Ede1vveiss/TPI/3-Documents/Pre-TPI/1391-3501-00 Rapport Liste de modification.docx

wETML

Pre-TPI Liste de modifications proposés du PCB Démonstrateur PID

Rapport R&D

Eden Wegger Funderskov

06/03/2024

Versions

Version | Date | Auteur | Remarques
00 | 2024-02-29 | EFV | Version initiale

# 1 Routage de l’alimentation

Durant le module de T&M5 j’ai eu la chance de toucher un peu au code de ce projet, cependant en mon ordinateur portable étant déjà connecté au nucléo pour le programmer, après avoir connecté le PCB j’ai remarqué que mon ordinateur portable n’était plus fonctionnel. (Il s’est avéré qu’il y a eu un courant en retour dans le port de charge usb, détruisant la carte mère)

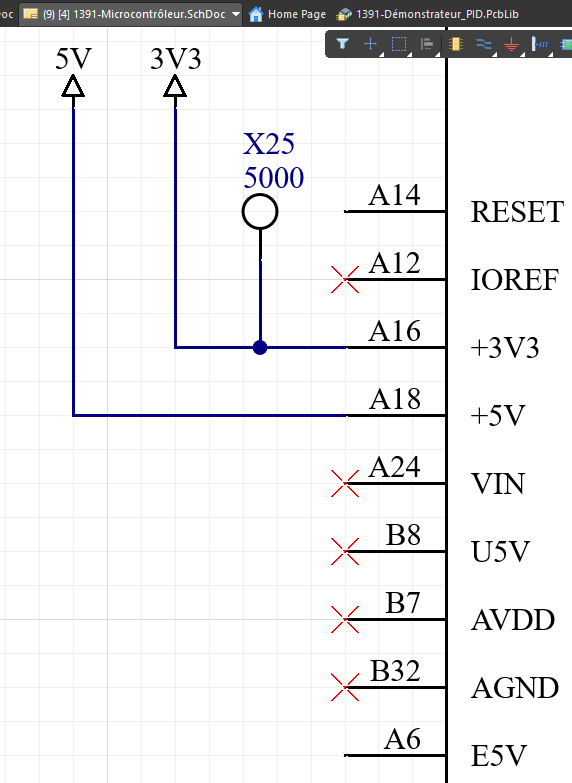
[picture p8: figure]
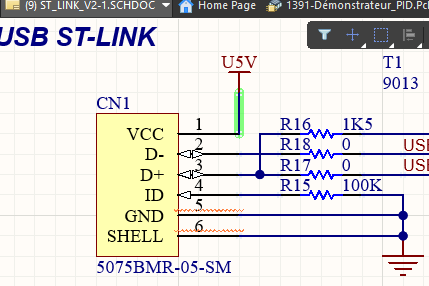
[picture p9: figure]
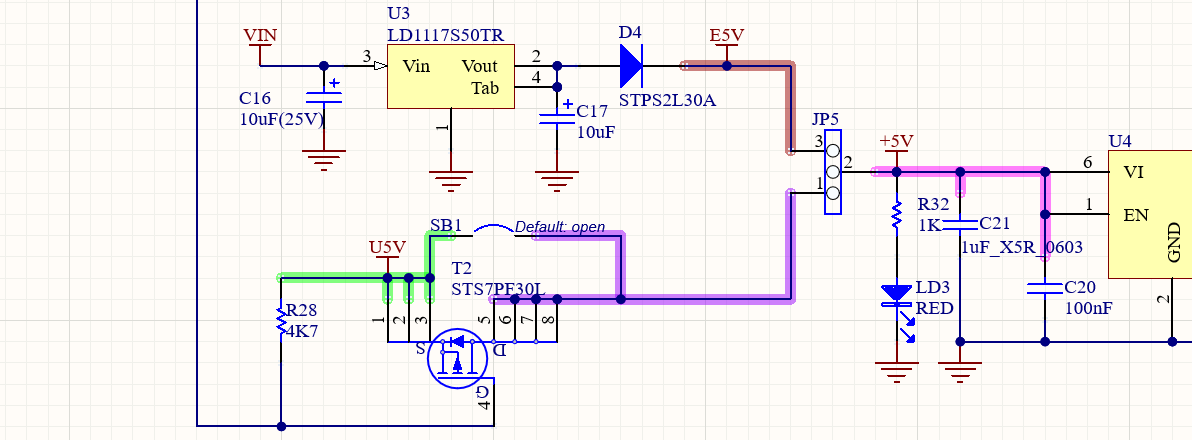
[picture p10: figure]

La cause que j’ai maintenant découvert durant mon pré-TPI est que le nucléo était alimenté par sa sortie +5V, alors que le port pour alimenter le nucléo est soi le Vin, ou soi le port E5V

Src : schémas du Nucléo F070RB

De ce que j’ai observé dans les datasheets, il n’existe pas une solution qui empêchera un risque à l’ordinateur connecté au Nucléo. Autre que des précautions d’utilisation, notamment d’alimenter le PCBA en premier puis connecter l’ordinateur au Nucléo. Cependant cela nécessitera de déconnecter l’ordi en cas de coupure de l’alimentation du PCBA.

# 2 Orientation des potentiomètres

Comme indiqué par l’auteur précédent du projet, il faut corriger les footprints des potentiomètres afin d’assurer que tourner les potentiomètres dans le sens des aiguilles d’une montre ou élever/éloigner le curseur du potentiomètre à barrette, de soi, augmente la valeur ADC obtenue sur le Nucléo.

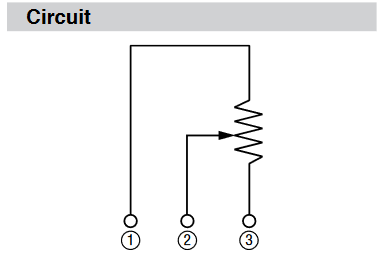
[picture p11: figure]

Dans la version que j’ai récupérée, le curseur des potentiomètres n’était pas sur le bon pin selon les datasheets.

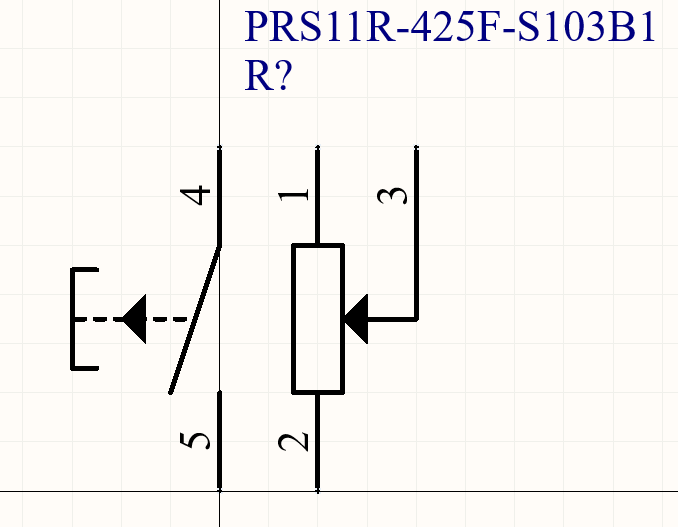
[picture p12: figure]
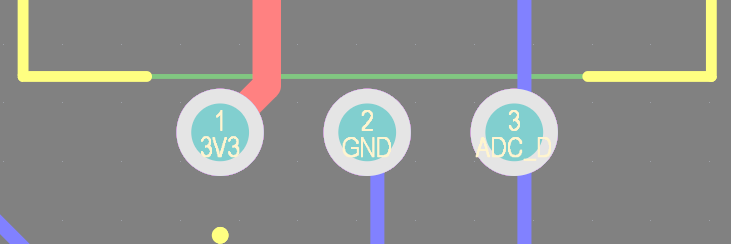
[picture p13: figure]

# 3 Taille des composants SMD

Voyant toute l’espace disponible sur le PCB il n’y a aucune raison, pour laquelle il serait nécessaire d’utiliser des composants aussi petites. En particulier pour les résistances et condensateurs

Page 2 sur 4

Auteur : EF Modifié par : Dernière modification le 06/03/2024 15:19 Page 0 sur 3 Créé le 29/02/2024 Imprimé le 23/03/2023 14:30 1391-3501-00 Rapport Liste de modification.docx

ETML Section électronique EFV – R&D – 1391.3503.00

ETML Section électronique TBI – R&D – 1391.3500.00
