Ede1vveiss/TPI/5-Hardware/1391-Demonstrateur_PID/1391-Démonstrateur_PID.html

Reporting Options

# File in Newer Format

Date | : | 20/03/2023
Time | : | 19:53:59
Project name | : | C:\Users\Xeryo\Education Vaud\ETML_XLO-19-23 - Blatti\Projets\1391-Demonstrateur_de_regulation_PID_TPI\5-Hardware\1391-Demonstrateur_PID\1391-Démonstrateur_PID.PrjPcb
Schematic documents | : | 1391-Affichage led.SchDoc , 1391-Alimentation.SchDoc , 1391-Microcontrôleur.SchDoc , 1391-Régulation.SchDoc , 1391-Schéma bloc.SchDoc

Version | Warning
21.9.0 | Internal Pull Up/Down resistor in components are not supported in this version.
22.3.0 | Custom diff pair suffixes are not supported in this version.

These files were generated in a later version of Altium Designer. Be aware that some data may have been added through functionality not available in your current version and will therefore not be available to you.
