Ede1vveiss/TPI/3-Documents/TPI/Mode d'emploi régulateur PID.docx

# Mode d’emploi Régulateur PID

# 1 But

Le but de ce document est de décrire succinctement l’utilisation du régulateur PID.

# 2 branchement

Vérifier qu’un nucléo STM32 F040RB est présent sur la carte avec le code de régulation dedans. Comme ci-dessous.

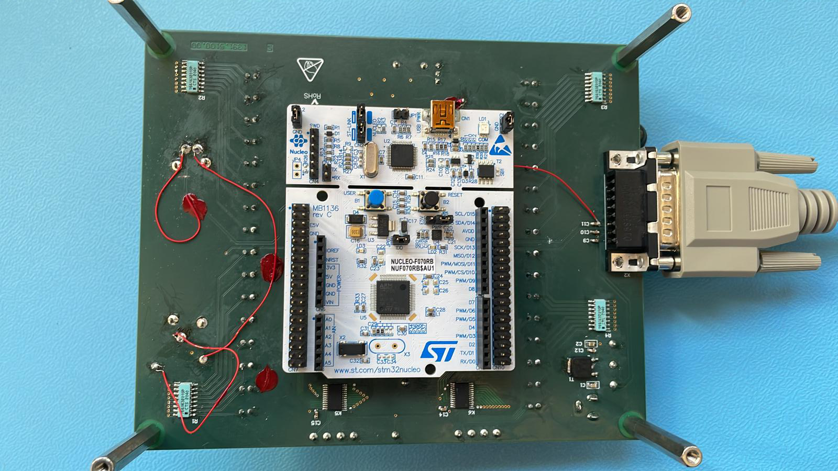
[picture p36: figure]

1 Carte nucléo

Si l’étape d’avant est validée vous pouvez alimenter la carte comme décris ci-dessous.

La carte est alimentée en 12V grâce à l’alimentation externe de la carte. Voir image ci-dessous.

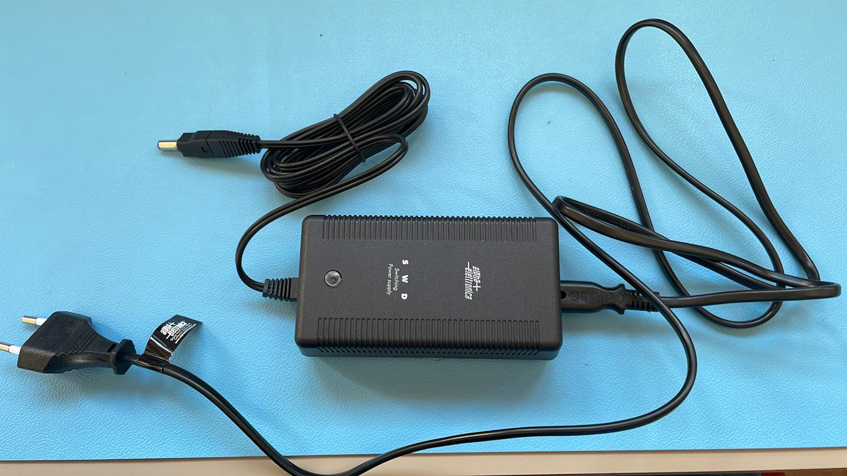
[picture p37: figure]

2 Alimentation

Assurez-vous que la carte est connectée à la tour grâce son câble Sub-D 15.

# 3 Utilisation

Voici une description visuelle de la carte.

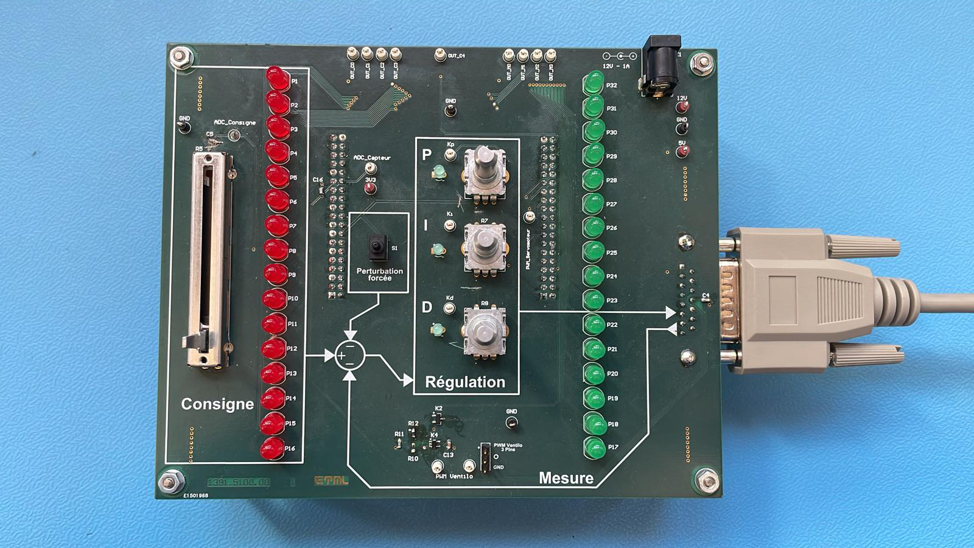
[picture p38: figure]

Sur la gauche de la carte, le potentiomètre linéaire permet de choisir à quelle hauteur la balle devrait monter avec sa représentation sur les leds rouge.

Au milieu se situe un bouton poussoir pour ajouter une erreur manuellement dans la régulation.

Les 3 potentiomètres P, I, D permettent de gérer précisément les valeurs de leur coefficient respectif.

A droite est représentée la valeur de la mesure sur les leds vertes en comparaison avec la valeur de consigne.

En bas se situe le système de choix n fonction de quel type de ventilateur est utilisé. (3pins ou 4pins)

Lausanne, le 10 mai 2023

Auteur : TB Modifié par : Dernière modification le 10/05/2023 14:32 Page 2 sur 2 Créé le 10/05/2023 Imprimé le 10/05/2023 14:33 Mode d'emploi régulateur PID.docx

Créé le 10/05/2023 Dernière modification le 10/05/2023 14:32 Page 1 sur 1 Imprimé le 10/05/2023 14:33 Mode d'emploi régulateur PID.docx

ETML Section électronique TBI – Mode d’emploi – 1391.3700.00
