Ede1vveiss/TPI/3-Documents/TPI/Structogramme/1391_Démonstrateur_PID.png

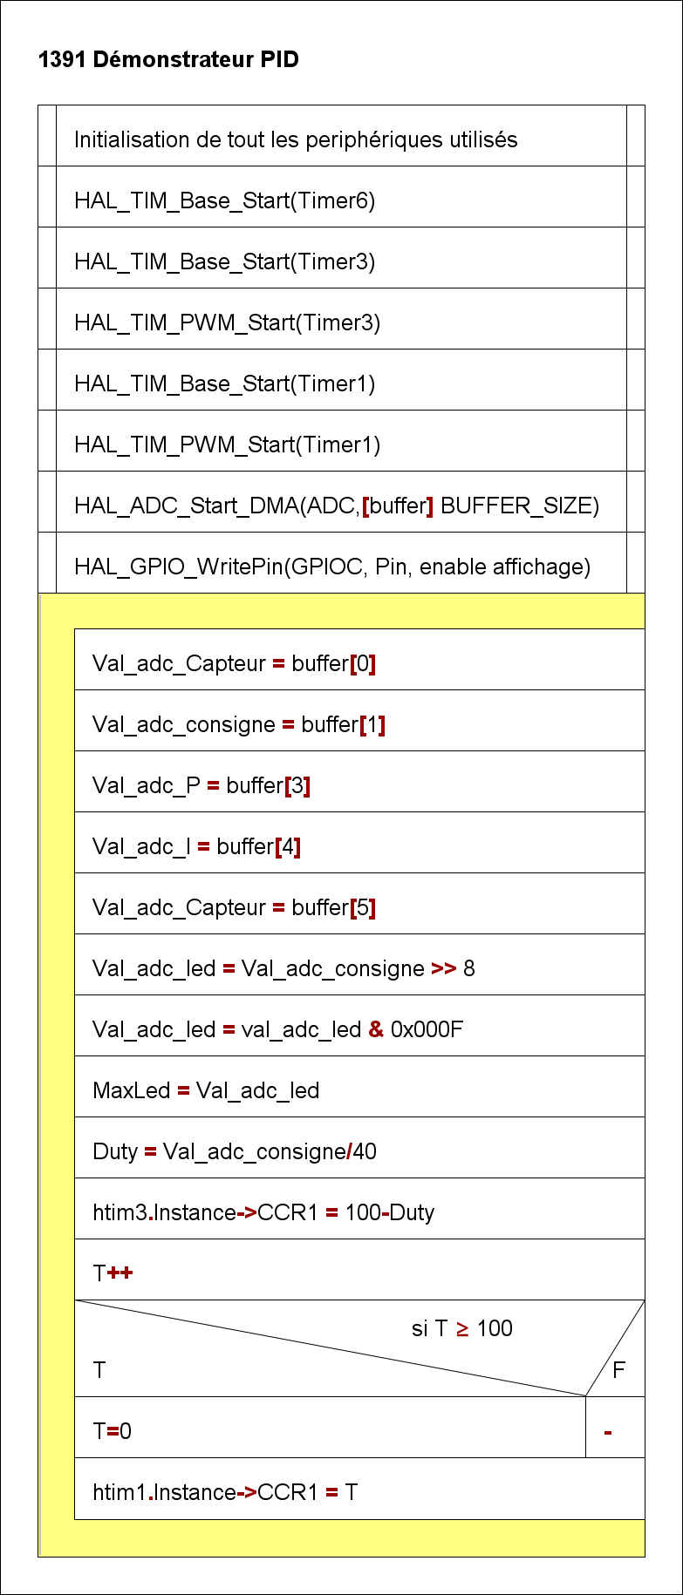
3-Documents/TPI/Structogramme/1391_Démonstrateur_PID.png
