Ede1vveiss/TPI/3-Documents/TPI/Structogramme/Affichage.png

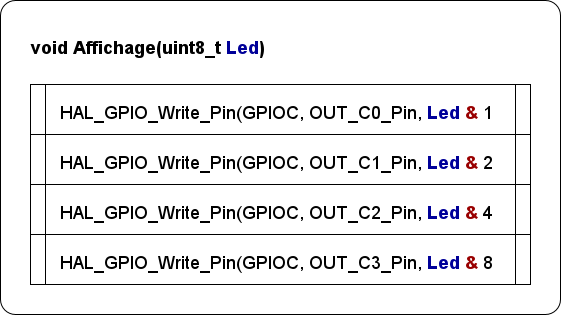
3-Documents/TPI/Structogramme/Affichage.png
