Ede1vveiss/TPI/3-Documents/TPI/Structogramme/ChoixLed-1.png

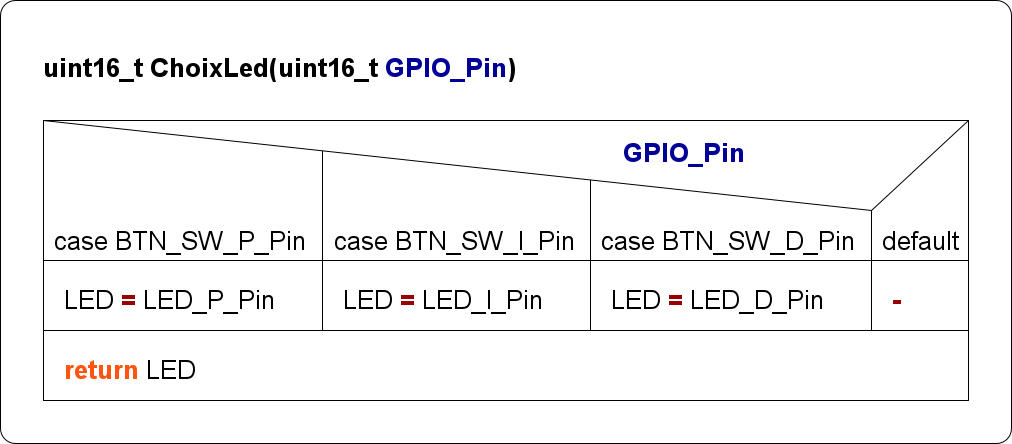
3-Documents/TPI/Structogramme/ChoixLed-1.png
