Ede1vveiss/TPI/3-Documents/TPI/Structogramme/HAL_GPIO_EXTI_Callback.png

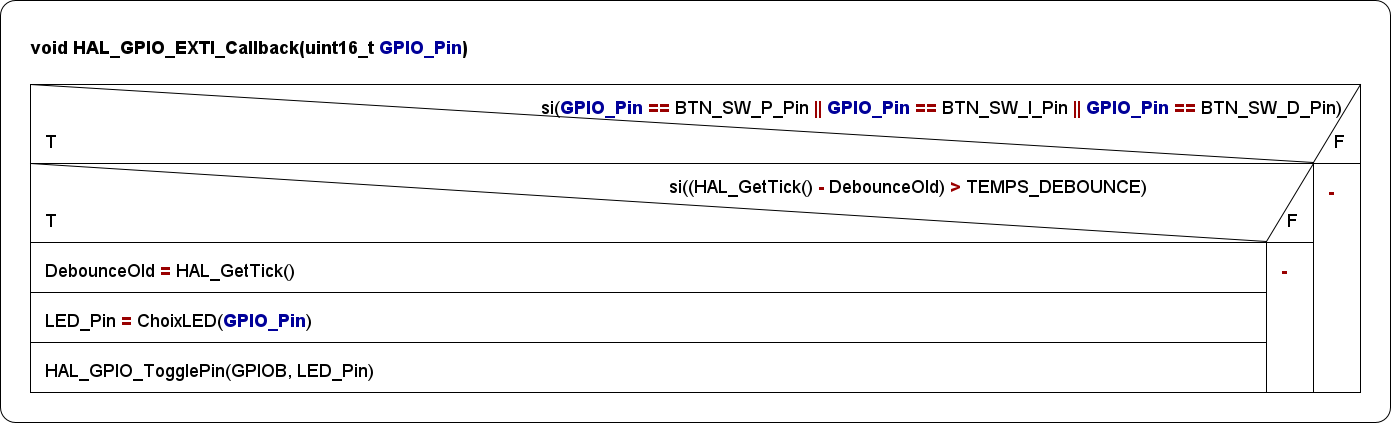
3-Documents/TPI/Structogramme/HAL_GPIO_EXTI_Callback.png
