Ede1vveiss/TPI/3-Documents/TPI/Structogramme/HAL_TIM_PeriodElapsedCallback.png

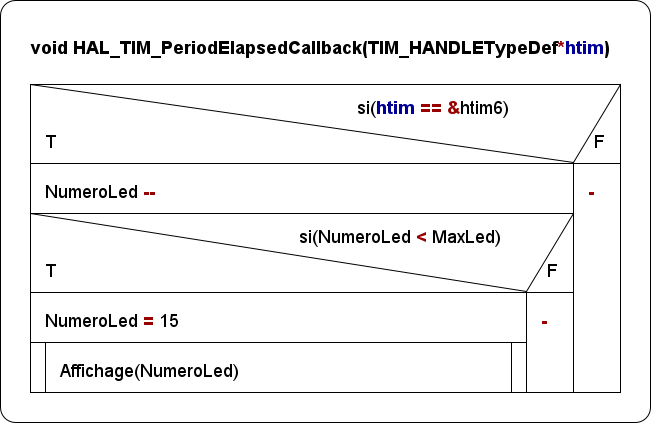
3-Documents/TPI/Structogramme/HAL_TIM_PeriodElapsedCallback.png
