Ede1vveiss/TPI/5-Hardware/1391-Demonstrateur_PID/Assembly/1391-Démonstrateur_PID_BOM.xlsx

 | Titre | Démonstrateur-PID |  | Numéro | 1391.5600.00 |  | ETML
 | Devise | <none> |  | Dessiné | TBI | 2023-03-16
 | Qté production | 1 |  | Controlé | - | -
Pos. | Designator | Description | PN | Quantity | Supplier 1 | Supplier Part Number 1 | Supplier Price 1 | Order Qty | Total | IsStocked
1 | 1 | PCB element for BOM | PN-108075 | 1 | Eurocircuits Sàrl | - | 0.0000 | 1 | 0.0000 | FALSE
2 | C1 | CAPC 100nF X7R 50V 10% 2012 (0805 INCH) | PN-747862 | 1 | ETML | FAB.0805_C 100n | 0.0200 | 1 | 0.0200 | 1
3 | C2 | CAPC 1uF X5R 25V 10% 2012 (0805 INCH) | PN-324029 | 1 | ETML | FAB.0805_C 1u | 0.0223 | 1 | 0.0223 | 1
4 | C3, C9, C10, C11, C12, C13, C14, C15 | CAPC 100nF X7R 50V 10% 1608 (0603 INCH) | PN-338083 | 8 | ETML | FAB.0603_C 100n | 0.0100 | 8 | 0.0800 | 1
5 | C4, C5, C6, C7, C8, C16 | CAPC 10nF X7R 50V 10% 1608 (0603 INCH) | PN-514948 | 6 | ETML | FAB.0603_C 10nF | 0.0123 | 6 | 0.0738 | 1
6 | K1 | NUCLEO-F070RB |  | 1 | Digikey | 497-15095-ND | 10.2200 | 1 | 10.2200
7 | K2 | TRAN 2N7002 N-Channel Enhancement MOSFET 60V 300mA | PN-648365 | 1 | Digikey | 2N7002K-7DITR-ND | 0.2000 | 1 | 0.2000 | 1
8 | K4 | IC BUFFER NON-INVERT 6V 5TSSOP |  | 1 | Digikey | 1727-3261-2-ND | 0.4300 | 1 | 0.4300
9 | K5, K6 | Integrated Circuit |  | 2 | Digikey | 1727-5944-2-ND | 1.5000 | 2 | 3.0000
10 | P1, P2, P3, P4, P5, P6, P7, P8, P9, P10, P11, P12, P13, P14, P15, P16 | LED 5mm 20 mA 2V 635nm Red | PN-959457 | 16 | ETML | MAG.232.228 | 0.2985 | 16 | 4.7760 | TRUE
11 | P17, P18, P19, P20, P21, P22, P23, P24, P25, P26, P27, P28, P29, P30, P31, P32 | LED 5mm 20 mA 2.4V 565nm Green | PN-297541 | 16 | ETML | MAG.232.231 | 0.1991 | 16 | 3.1856 | TRUE
12 | P36, P37, P38 | LED 3mm Cylinder 20 mA 2V 625nm Red | PN-643196 | 3 | Digikey | L71531-ND | 0.8900 | 3 | 2.6700 | FALSE
13 | R1, R2, R3, R4 | RES ARRAY 8 RES 200 OHM 16SOIC |  | 4 | Digikey | 766-163-R200P-ND | 2.0100 | 4 | 8.0400
14 | R5 | POT 10K OHM 1/20W LINEAR |  | 1 | Digikey | PTA4543-2015DPB103-ND | 1.7800 | 1 | 1.7800
15 | R6, R7, R8 | 20 mm Rotary Metal Shaft Potentiometer |  | 3 | Digikey | 118-PRS11R-225F-S103B1-ND | 3.5100 | 3 | 10.5300
16 | R9, R11, R13, R14, R15 | RES 100kohm ±1% 0.1W 1608 (0603 INCH) | PN-525286 | 5 | ETML | FAB.0603_R 100k | 0.0100 | 5 | 0.0500 | 1
17 | R10, R12 | RES 10kohm ±1% 0.1W 1608 (0603 INCH) | PN-896786 | 2 | ETML | FAB.0603_R 10k | 0.0200 | 2 | 0.0400 | 1
18 | R16, R17, R18 | RES 150ohm ±1% 0.1W 1608 (0603 INCH) | PN-977870 | 3 | ETML | FAB.0603_R 150R | 0.0200 | 3 | 0.0600 | 1
19 | S1 | A9PS26-0011 |  | 1 | Digikey | SW1380-ND | 6.0500 | 1 | 6.0500
20 | T1 | Positive Voltage Regulator, 5V, 3-Pin DPAK, Tape and Reel |  | 1 | Digikey | 497-1203-2-ND | 0.6600 | 1 | 0.6600
21 | X1 | Power Barrel Connector Jack 2.10mm ID (0.083), 5.50mm OD (0.217) Through Hole, Right Angle |  | 1 | Digikey | EJ503A-ND | 1.2800 | 1 | 1.2800
22 | X2 | Connector |  | 1 | Digikey | 609-1498-ND | 2.5100 | 1 | 2.5100
23 | X3, X4, X5, X6, X7, X8, X9, X10, X11, X12, X13, X14, X15, X22, X23, X24, X26 | TEST THT MINIATURE WT | PN-357949 | 17 | ETML | MAG.428.013 | 0.2931 | 17 | 4.9827 | TRUE
24 | X16, X17, X25 | TEST THT MINIATURE RD | PN-119866 | 3 | ETML | MAG.428.012 | 0.2708 | 3 | 0.8124 | TRUE
25 | X18, X19, X20, X21 | TEST THT MINIATURE BK | PN-688907 | 4 | ETML | MAG.428.011 | 0.2600 | 4 | 1.0400 | TRUE
26 | X28 | JUMPER 2.54 1x03 | PN-771444 | 1 | ETML | MAG.283.897 | 0.0600 | 1 | 0.0600 | TRUE
 |  |  |  |  |  |  | Totaux | 104 | 62.57
