Ede1vveiss/TPI/5-Hardware/1391-Demonstrateur_PID/3D altium library/74LVC1G125GV,125.stp

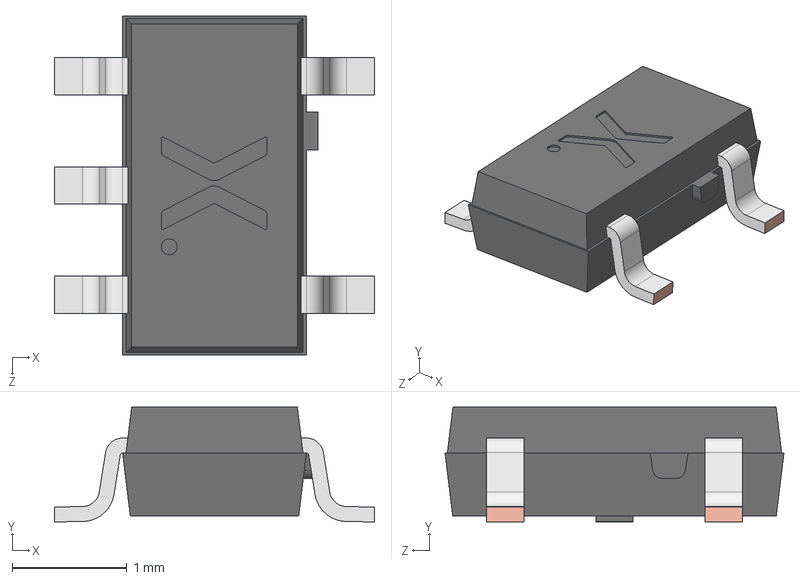
[picture p44: CAD file, 2024-03-13]
5-Hardware/1391-Demonstrateur_PID/3D altium library/74LVC1G125GV,125.stp
2.79 x 1.00 x 2.95 mm
SOT753 Lower mold body
SOT753 Lead x 5
SOT753 Upper mold body
