Ede1vveiss/TPI/5-Hardware/1391-Demonstrateur_PID/3D altium library/PTA4543-2015DPB103.step

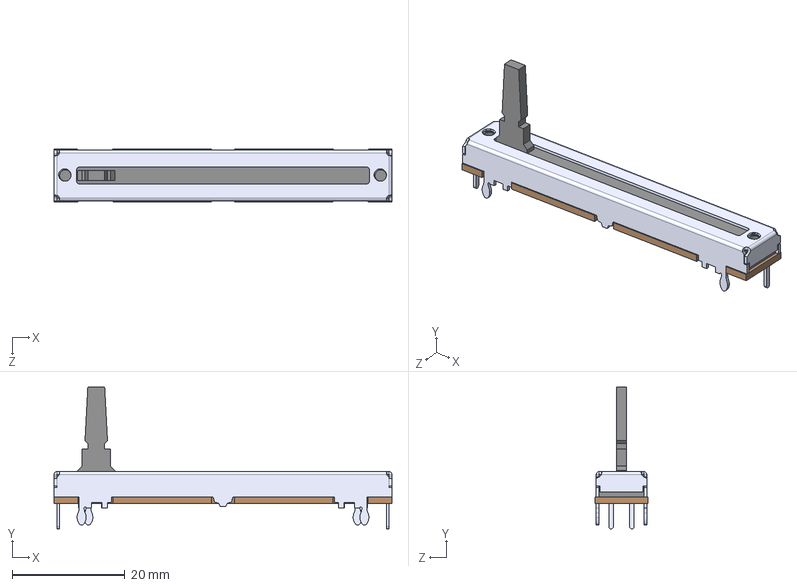
[picture p45: CAD file, 2024-03-13]
5-Hardware/1391-Demonstrateur_PID/3D altium library/PTA4543-2015DPB103.step
60.0 x 25.2 x 9.40 mm
