Ede1vveiss/TPI/5-Hardware/1391-Demonstrateur_PID/3D altium library/EJ503A.step

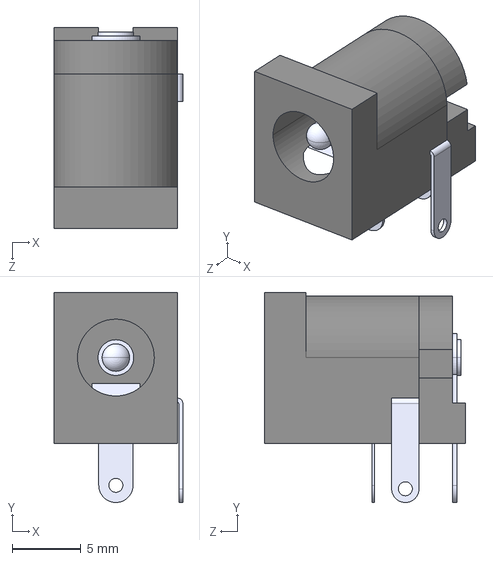
[picture p46: CAD file, 2024-03-13]
5-Hardware/1391-Demonstrateur_PID/3D altium library/EJ503A.step
9.38 x 15.3 x 14.6 mm
