Ede1vveiss/TPI/5-Hardware/1391-Demonstrateur_PID/3D altium library/MC74VHC1G08DBVT1G-Q.stp

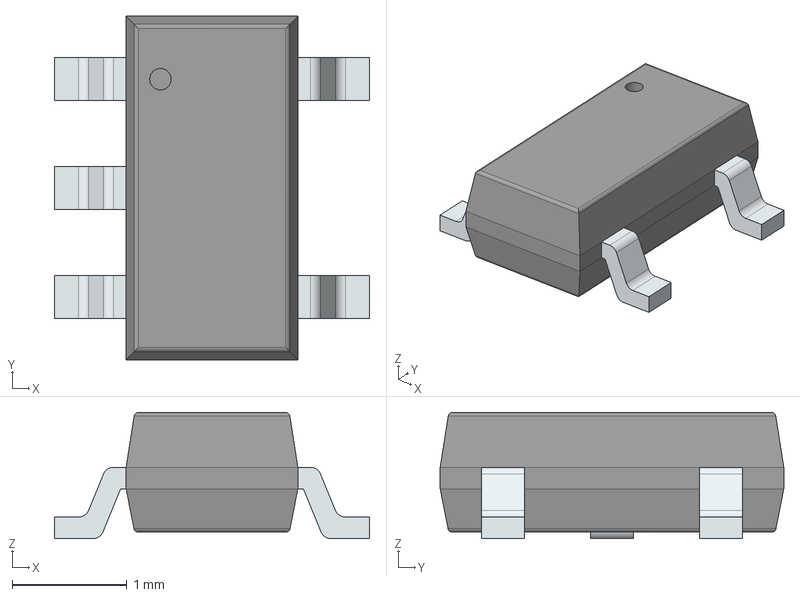
[picture p47: CAD file, 2024-03-13]
5-Hardware/1391-Demonstrateur_PID/3D altium library/MC74VHC1G08DBVT1G-Q.stp
2.75 x 3.00 x 1.10 mm
PinsArrayL
PinsArrayR
