Ede1vveiss/TPI/5-Hardware/1391-Demonstrateur_PID/Assembly/1391-Démonstrateur_PID_PCB.PDF

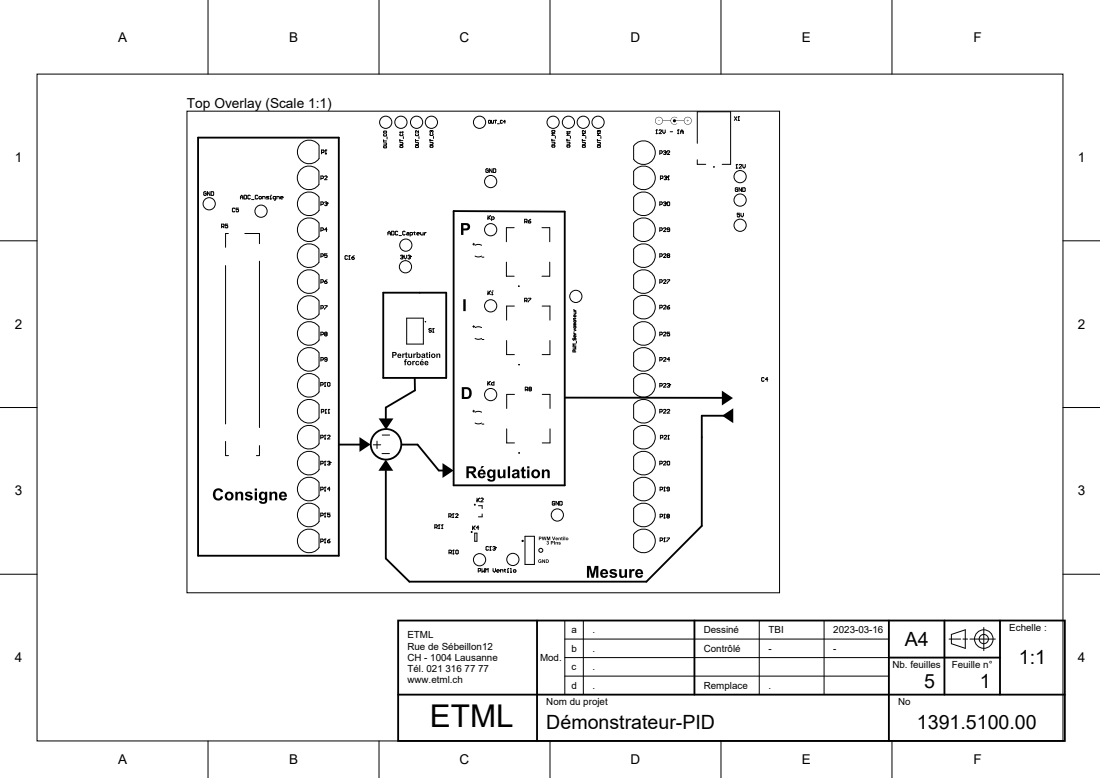
[picture p48: page 1]

ETML Rue de Sébeillon12 CH - 1004 Lausanne Tél. 021 316 77 77 www.etml.ch | Mod. | a | . | Dessiné | TBI | 2023-03-16 | A4 | | Echelle : 1:1

b | . | Contrôlé | - | -
c | . | | | | Nb. feuilles 5 | Feuille n° 1
d | . | Remplace | .

ETML | Nom du projet Démonstrateur-PID | | | | | | No 1391.5100.00

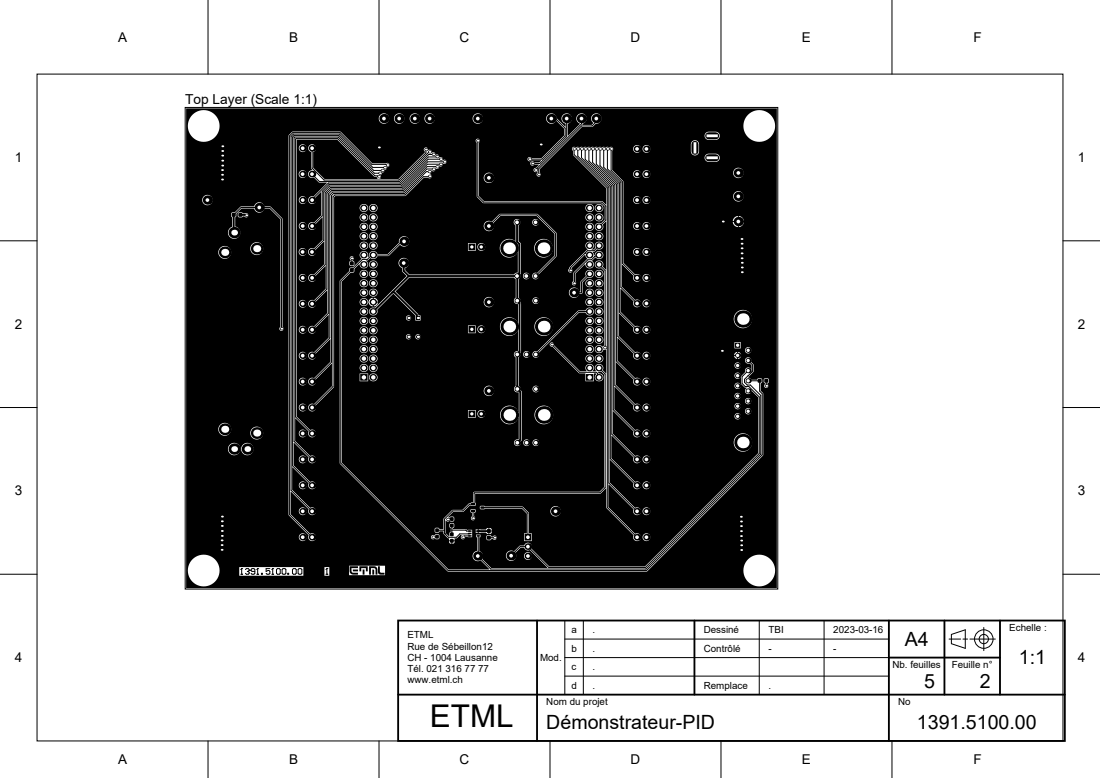
[picture p49: page 2]
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

b | . | Contrôlé | - | -
c | . | | | | Nb. feuilles 5 | Feuille n° 2
d | . | Remplace | .

ETML | Nom du projet | | | | | | No

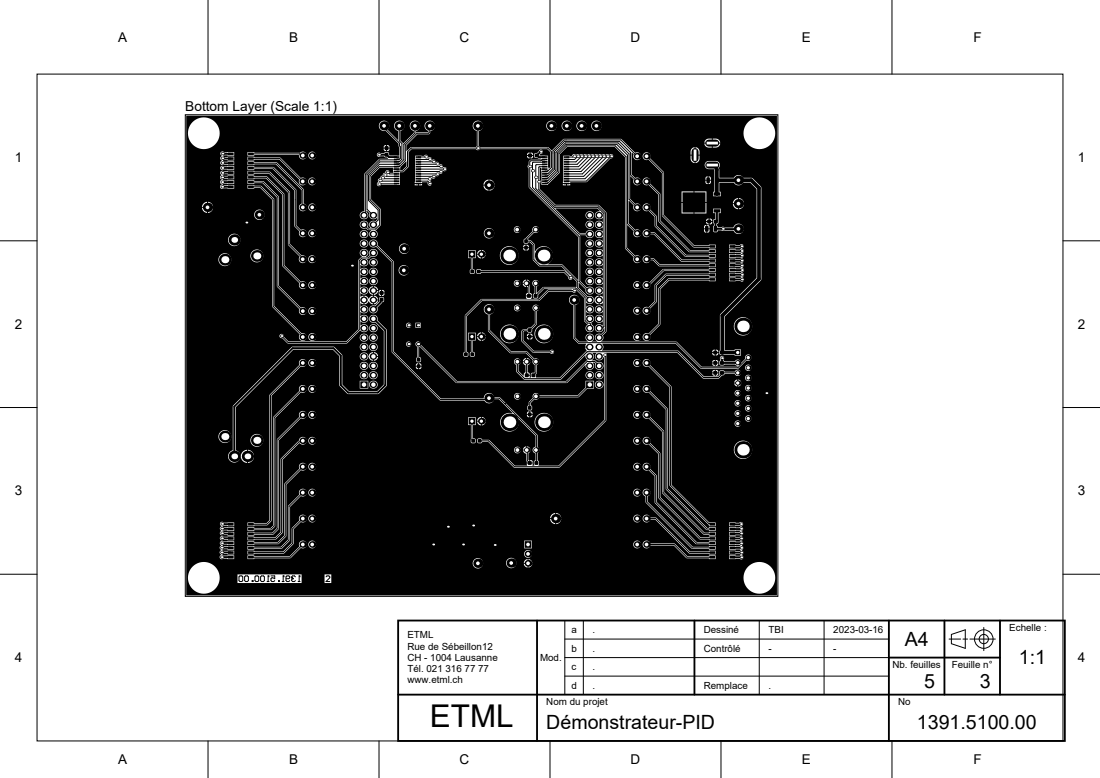
[picture p50: page 3]
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

b | . | Contrôlé | - | -
c | . | | | | Nb. feuilles 5 | Feuille n° 3
d | . | Remplace | .

ETML | Nom du projet | | | | | | No

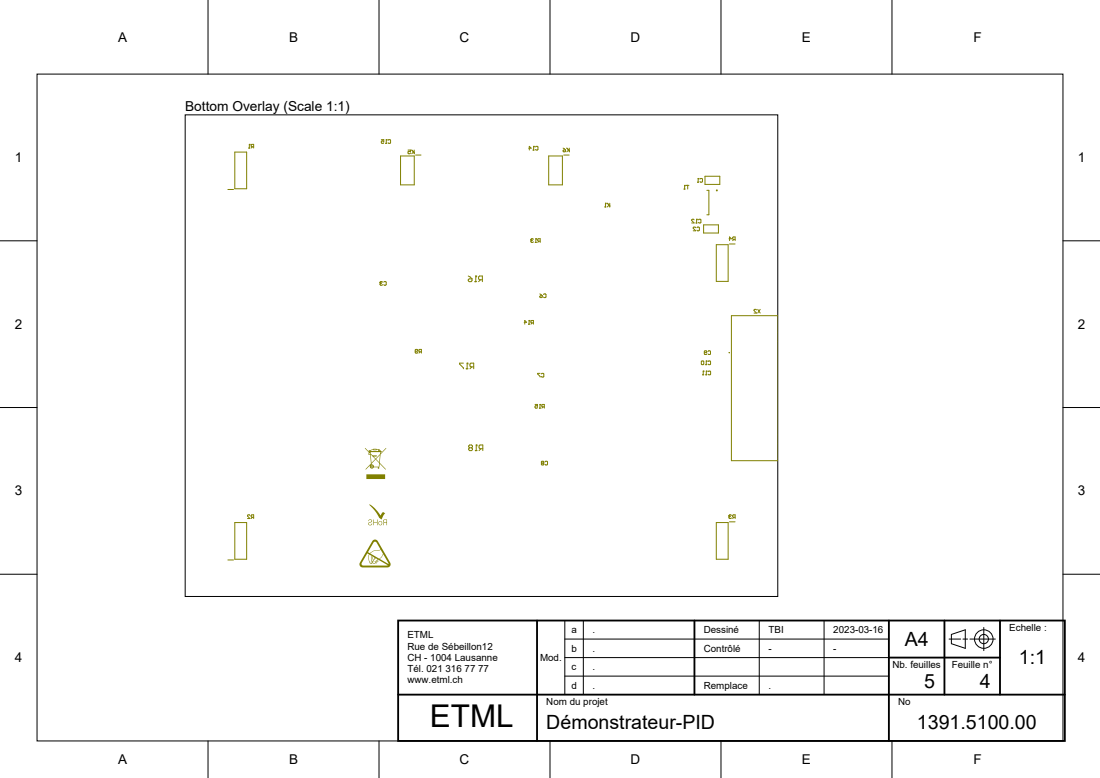
[picture p51: page 4]
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

b | . | Contrôlé | - | -
c | . | | | | Nb. feuilles 5 | Feuille n° 4
d | . | Remplace | .

ETML | Nom du projet | | | | | | No

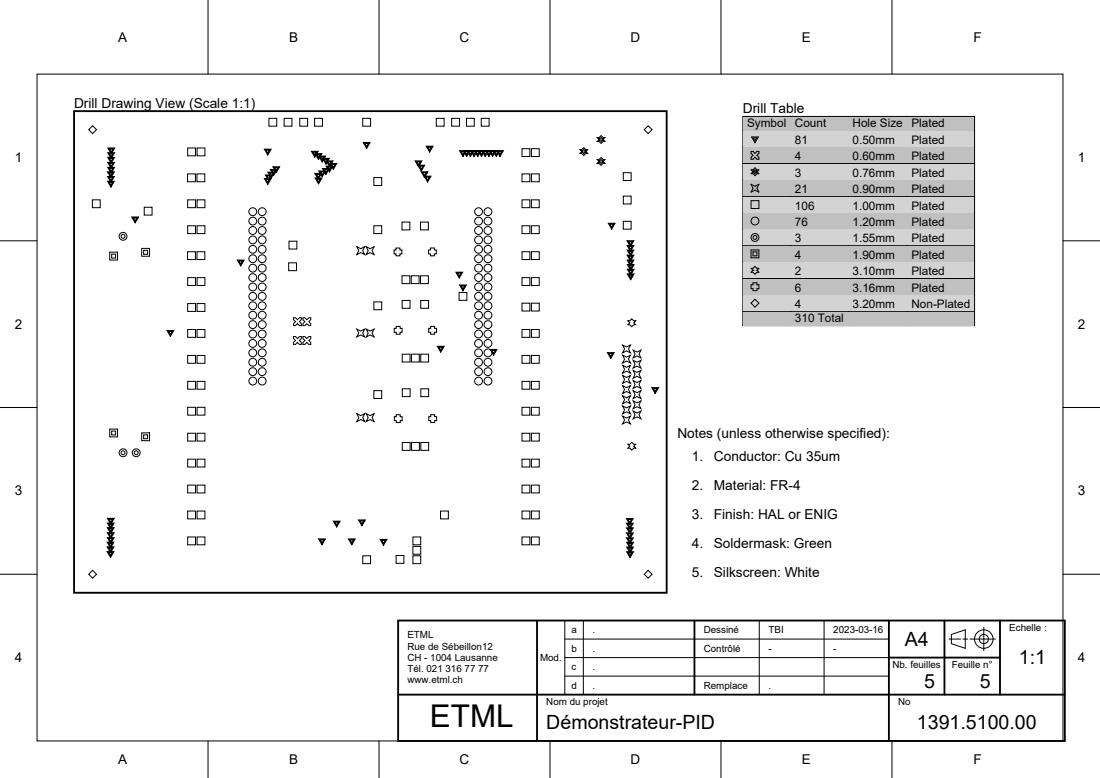
[picture p52: page 5]

Drill Drawing View (Scale 1:1)

Symbol | Count | Hole Size | Plated

81 | 0.50mm | Plated
4 | 0.60mm | Plated
3 | 0.76mm | Plated
21 | 0.90mm | Plated
106 | 1.00mm | Plated
76 | 1.20mm | Plated
3 | 1.55mm | Plated
4 | 1.90mm | Plated
2 | 3.10mm | Plated
6 | 3.16mm | Plated
4 | 3.20mm | Non-Plated
310 Total

Notes (unless otherwise specified):
1. Conductor: Cu 35um

3. Finish: HAL or ENIG

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

b | . | Contrôlé | - | -
c | . | | | | Nb. feuilles 5 | Feuille n° 5
d | . | Remplace | .

ETML | Nom du projet | | | | | | No
