Ede1vveiss/TPI/5-Hardware/1391-Demonstrateur_PID/Assembly/1391-Démonstrateur_PID_SCH PRE-TPI.PDF

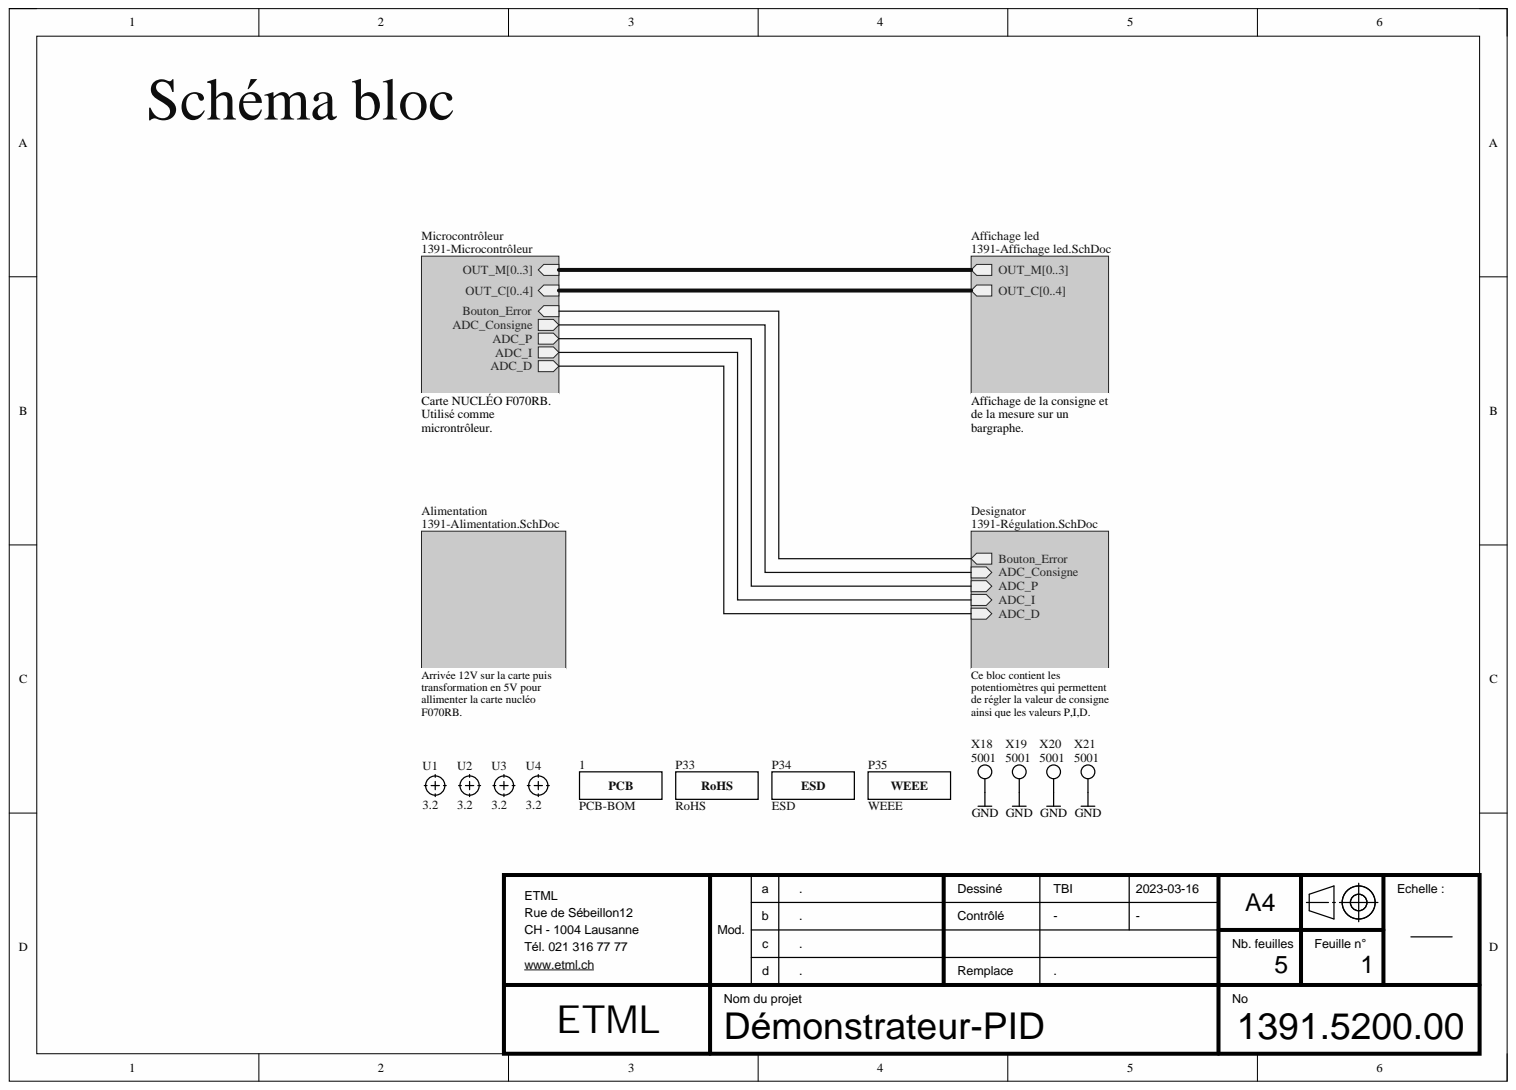
[picture p53: page 1]

Affichage de la consigne et
de la mesure sur un
bargraphe.

Arriv
transformation en 5V pour
allimenter la carte nucl

ée 12V sur la carte puis

Ce bloc contient les
potentiom
ainsi que les valeurs P,I,D.

ètres qui permettent
égler la valeur de consigne

ETML Rue de S ébeillon12 CH - 1004 Lausanne Tél. 021 316 77 77 www.etml.c h | Mod. | | | Dessin é | 2023-03-16 | A4 | | Echelle :

abcd | .... | Contr ô l é | -

Nb. feuilles 5 | Feuille n ° 1

Remplace

ETML | Nom du projet D émonstrateur-PID | | No 1391.5200.00

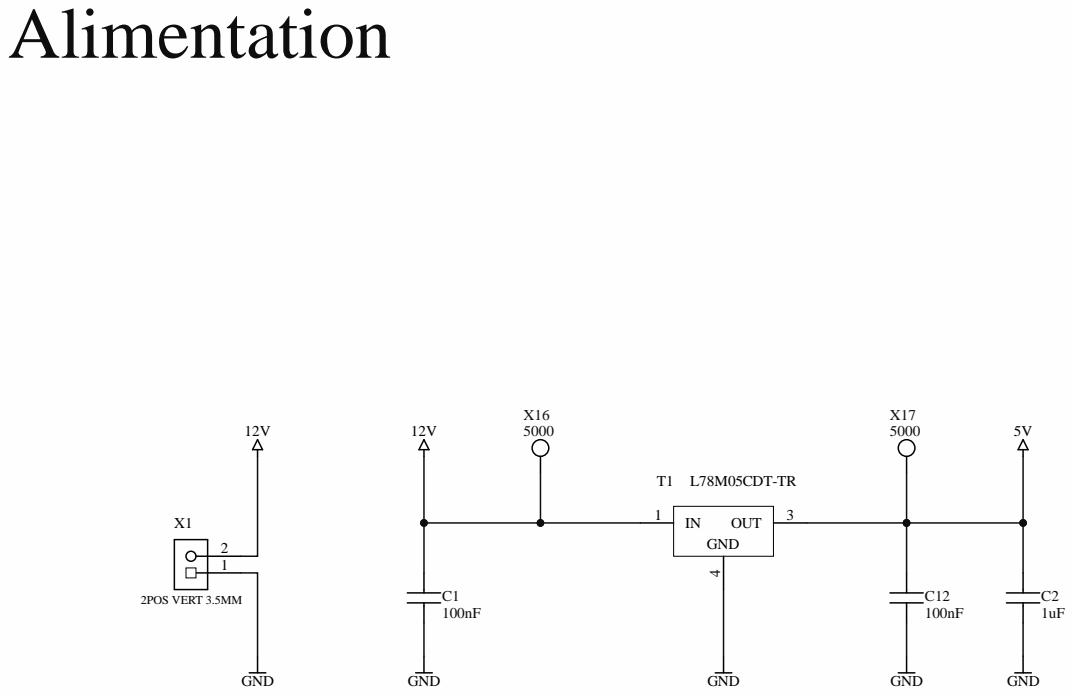
[picture p54: page 2]
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

abcd | .... | Contr ô l é | -

Nb. feuilles 5 | Feuille n ° 2

Remplace

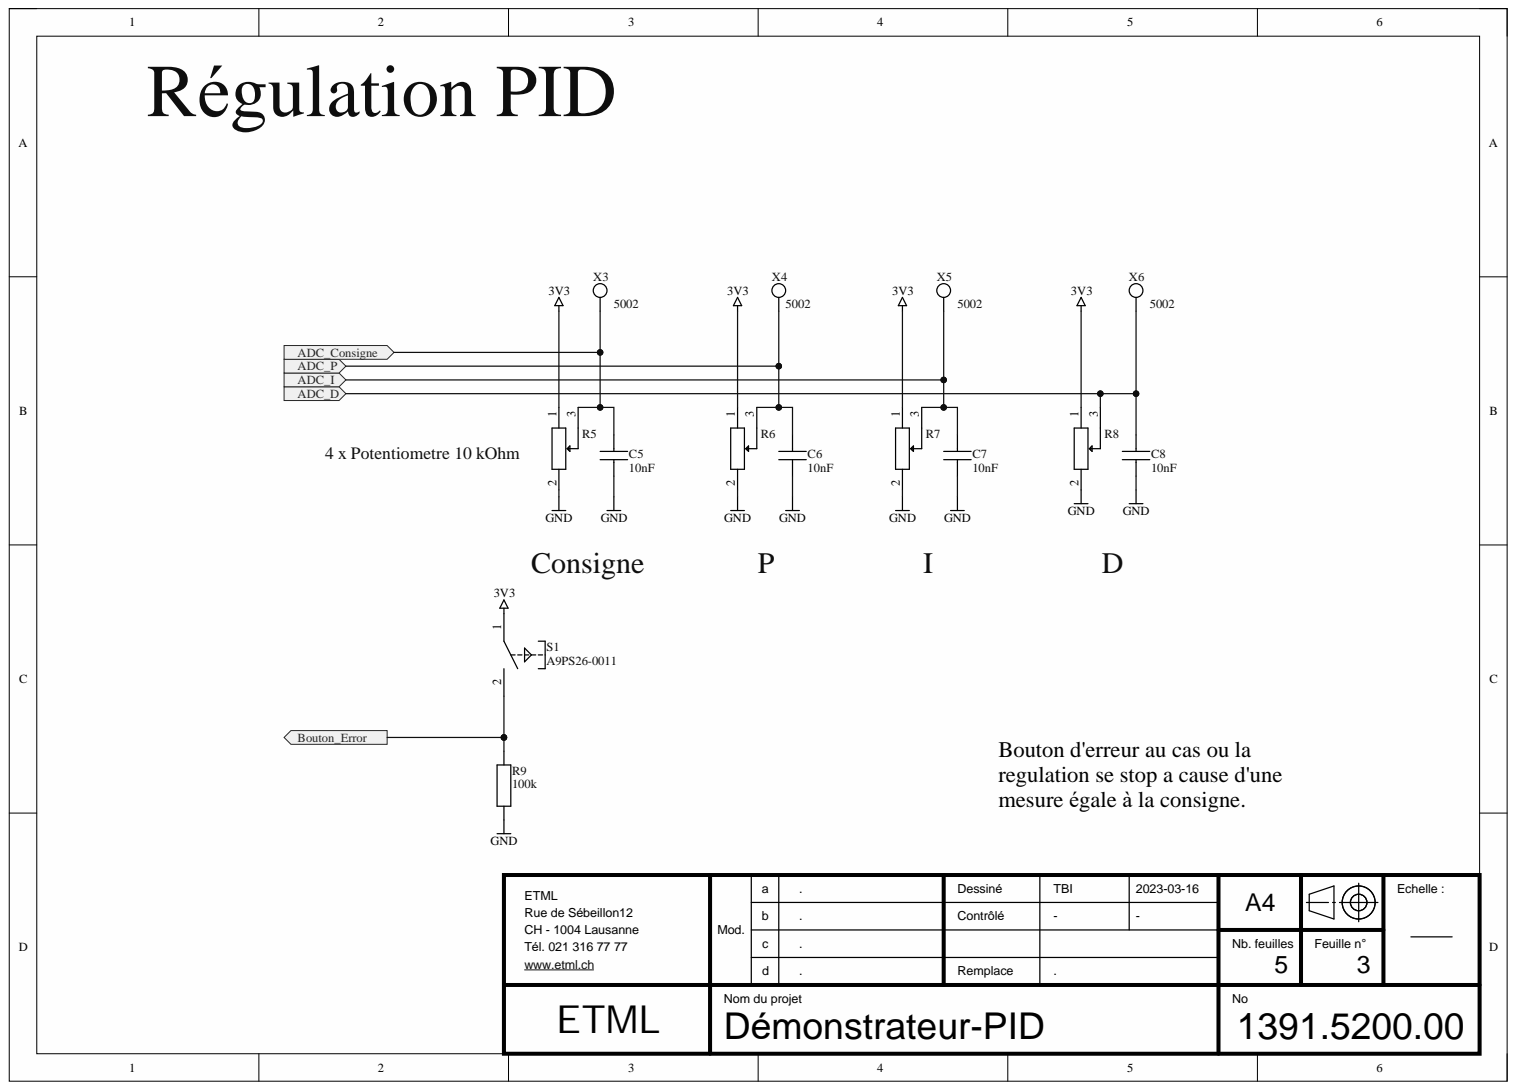
[picture p55: page 3]

Bouton d'erreur au cas ou la
regulation se stop a cause d'une
mesure

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

abcd | .... | Contr ô l é | -

Nb. feuilles 5 | Feuille n ° 3

Remplace

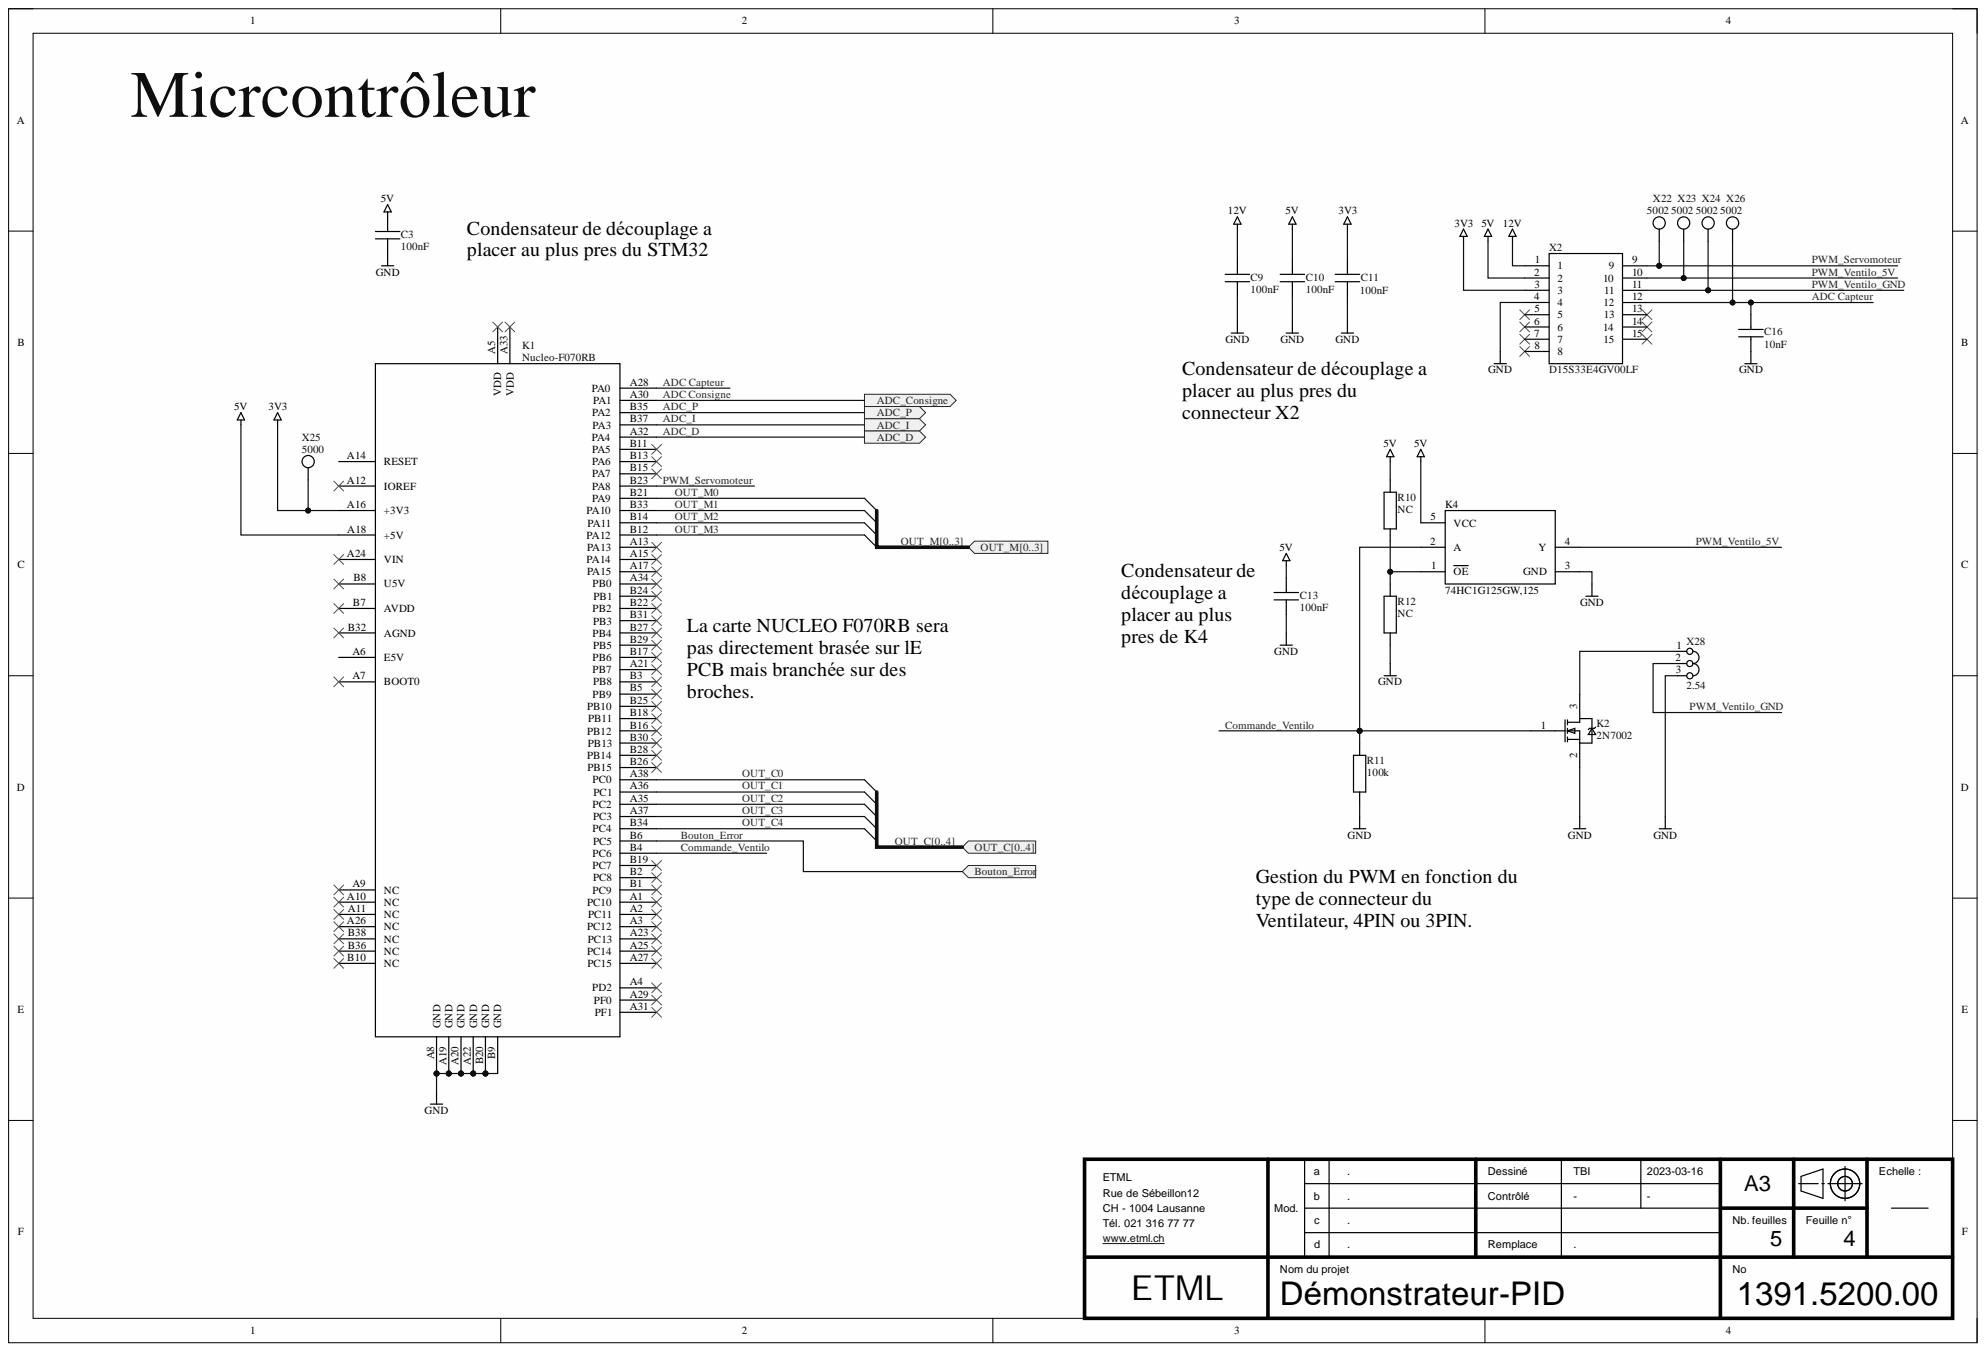
[picture p56: page 4]

placer au plus pres d

ET M L Rue de S ébeillon12 C H - 1004 Lausanne T él. 021 316 77 77 w w w .et m l . c h | Mod . | | | Des sin é | 2023-03-16 | A3 | Echelle :

abcd | .... | Cont r ô l é | -

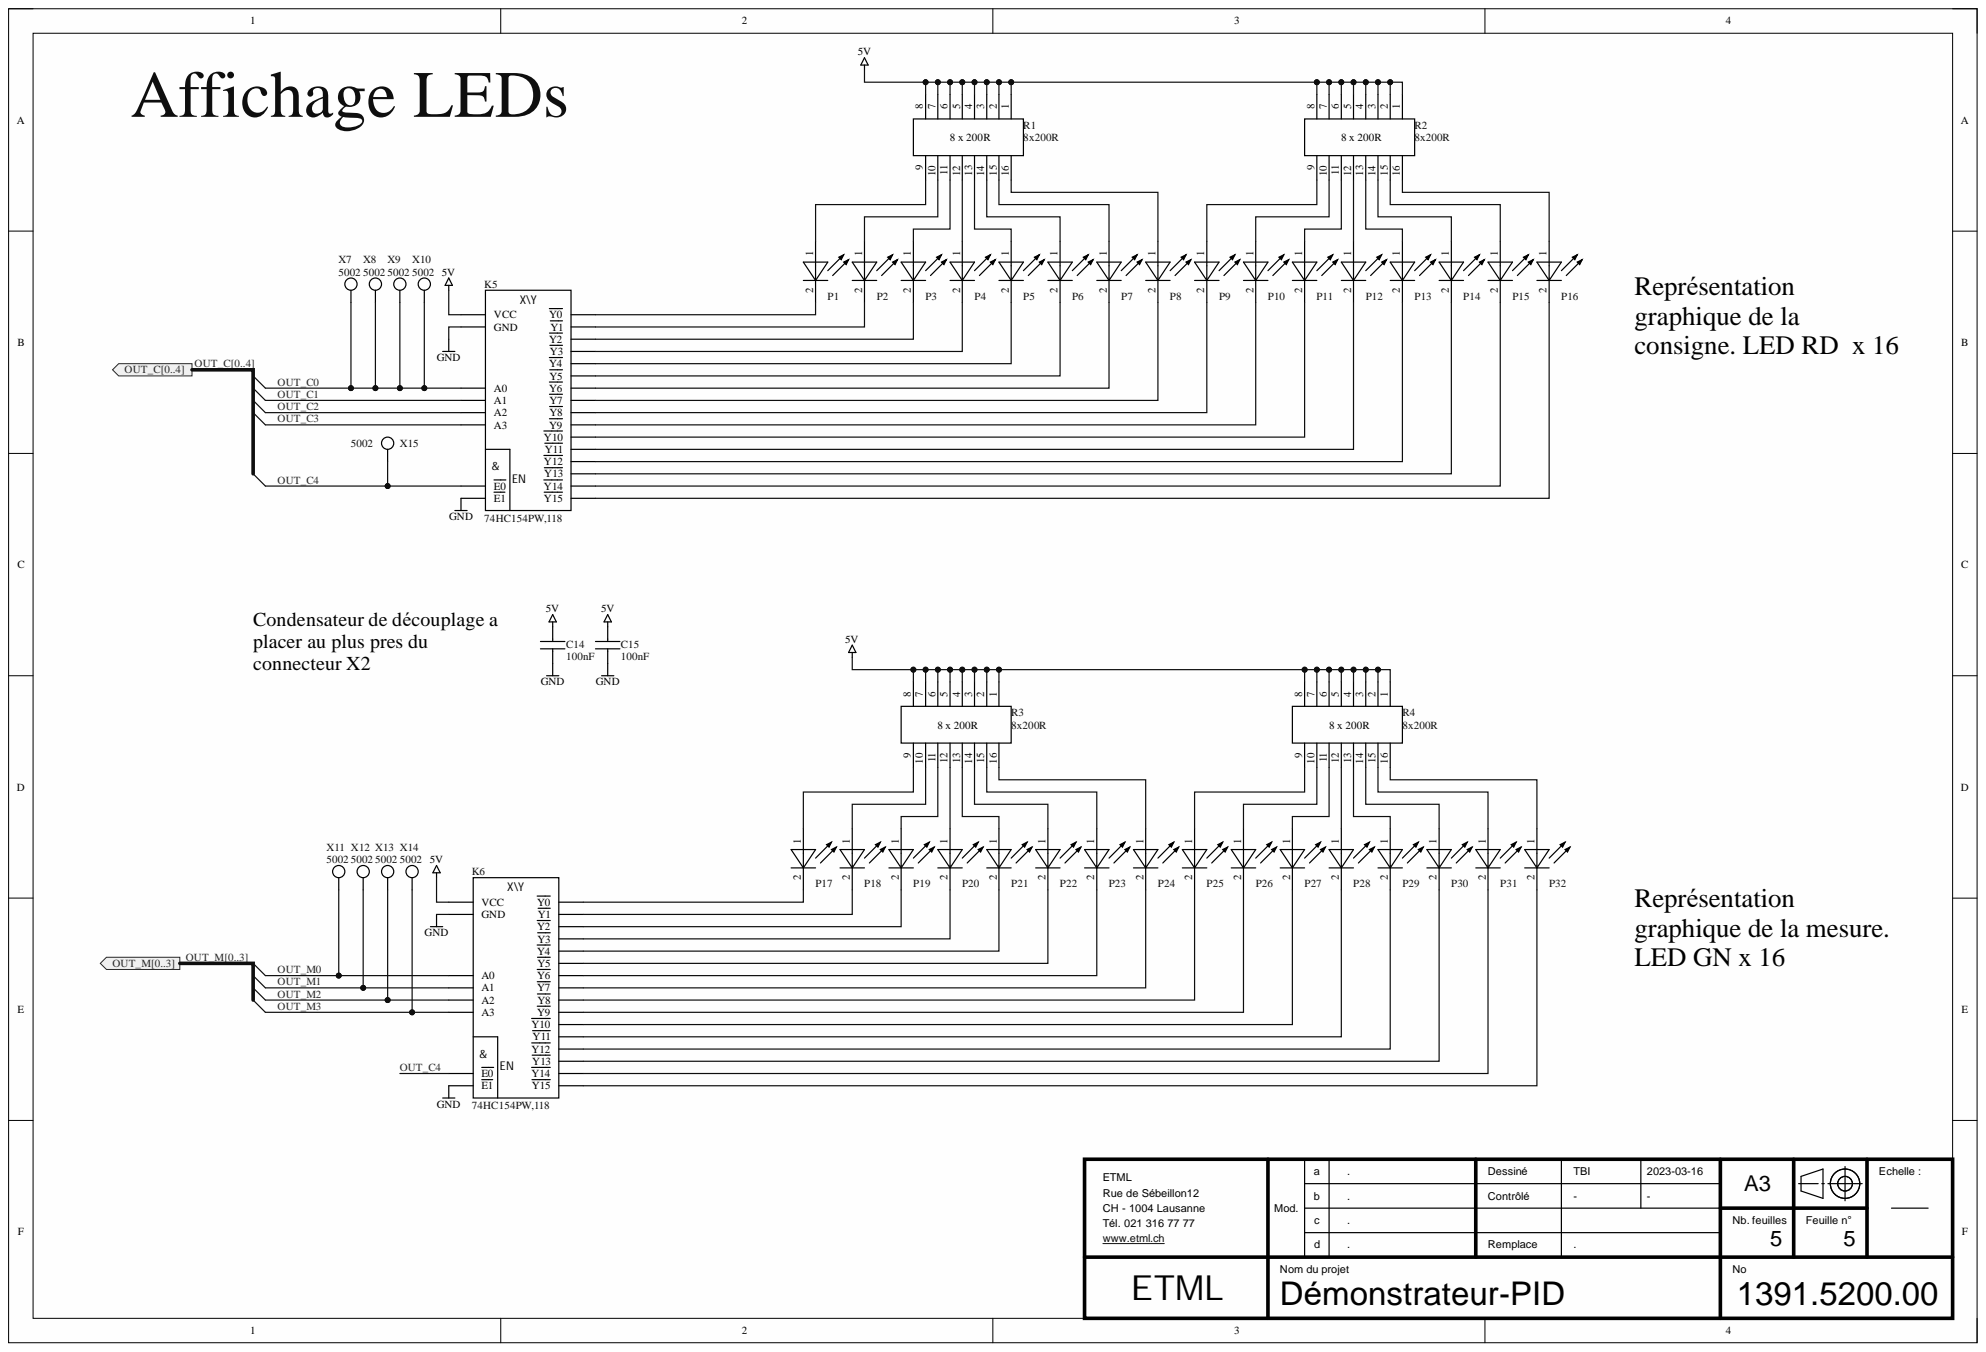
[picture p57: page 5]

Condensateur de découplage a
placer au plus pres du
connecteur X2

Représentation
graphique de la mesure.
LED GN x 16

ETML Rue de Sébeillon12 CH - 1004 Lausanne Tél. 021 316 77 77 www.etml.ch | Mod. | a | . | Dessiné | TBI | 2023-03-16 | A3 | | Echelle :

b | . | Contrôlé | - | -

c | . | | | | Nb. feuilles 5 | Feuille n° 5

d | . | Remplace | .
Démonstrateur-PID | | | | | | 1391.5200.00
