Ede1vveiss/TPI/5-Hardware/1391-Demonstrateur_PID/Assembly/1391-Démonstrateur_PID_ASY.PDF

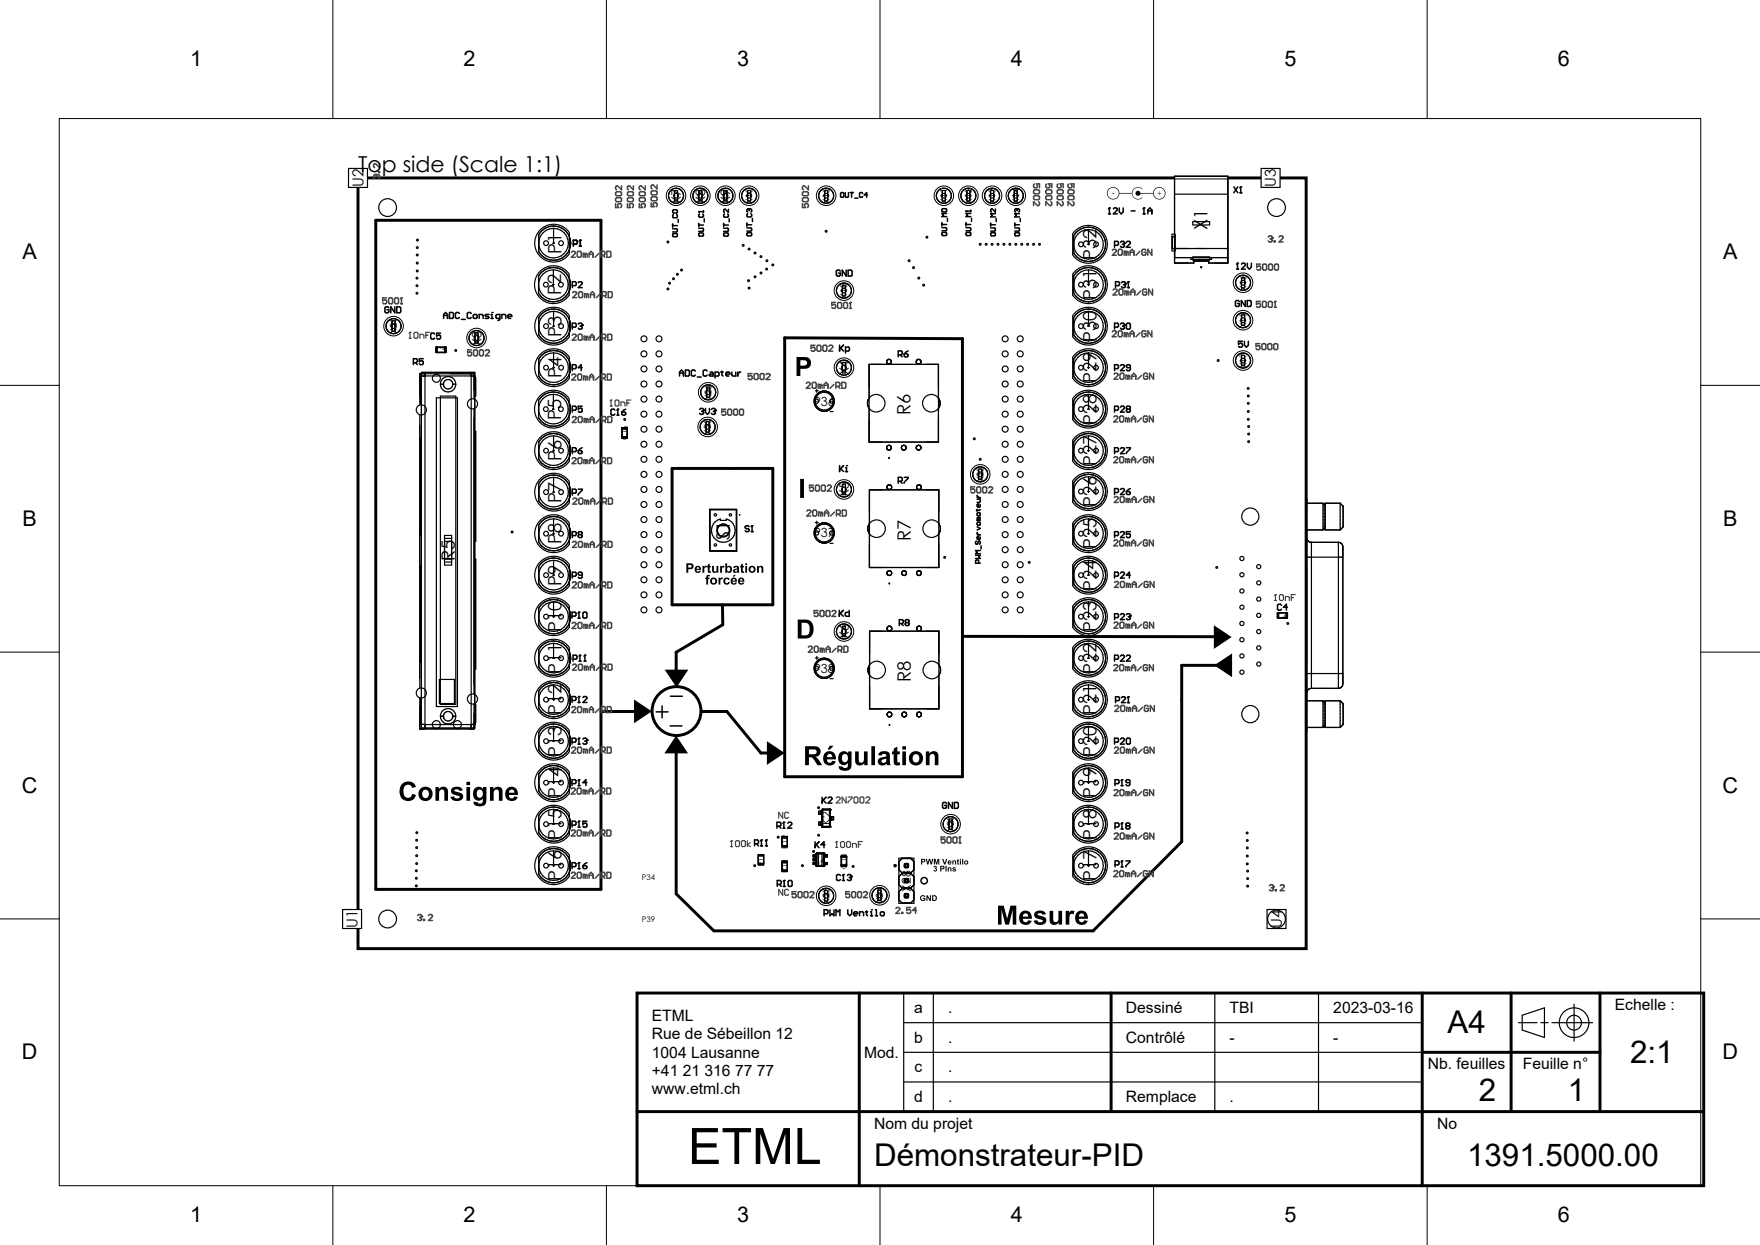
[picture p63: page 1]

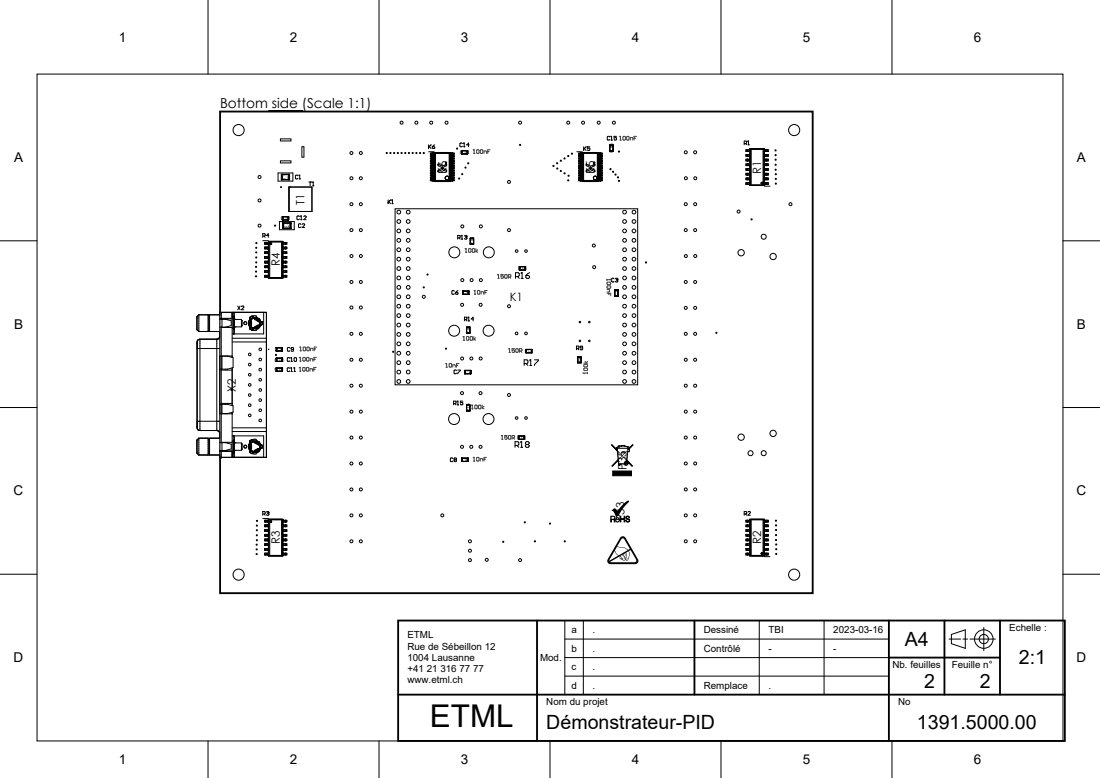
[picture p64: page 2]
