Ede1vveiss/TPI/(list of files, drawings)

Other design files:
5-Hardware/1391-Demonstrateur_PID/74LVC1G125GV_125.SchLib
5-Hardware/1391-Demonstrateur_PID/1391-Affichage led.SchDoc
5-Hardware/1391-Demonstrateur_PID/1391-Démonstrateur_PID.PrjPcb
5-Hardware/1391-Demonstrateur_PID/1391-Démonstrateur_PID.SCHLIB
5-Hardware/1391-Demonstrateur_PID/1391-Microcontrôleur.SchDoc
5-Hardware/1391-Demonstrateur_PID/1391-Régulation.SchDoc
5-Hardware/1391-Demonstrateur_PID/1391-Schéma bloc.SchDoc
5-Hardware/1391-Demonstrateur_PID/Add Components.PcbLib
5-Hardware/1391-Demonstrateur_PID/EJ503A/EJ503A.SchLib
5-Hardware/1391-Demonstrateur_PID/EJ503A/MPD_EJ503A.PcbLib
5-Hardware/1391-Demonstrateur_PID/IC BUFFER NON-INVERT 6V 5TSSOP.PcbLib
5-Hardware/1391-Demonstrateur_PID/MC74VHC1G08DBVT1G-Q.SchLib
5-Hardware/1391-Demonstrateur_PID/PRS11R425FS103B1.PcbLib
5-Hardware/1391-Demonstrateur_PID/PRS11R-425F-S103B1.SchLib
5-Hardware/1391-Demonstrateur_PID/PTA4543-2015DPB103/TRIM_PTA4543-2015DPB103.PcbLib
5-Hardware/1391-Demonstrateur_PID/SOT95P275X110-5N.PcbLib
