Ede1vveiss/TPI/(commit log)

2024-02-29 Folder update
    setup
    [IR distance click excel.xlsx]
2024-03-04 Added Hardware part
    altium docs
    [1391-Affichage led.SchDoc, 1391-Alimentation.SchDoc, 1391-Démonstrateur_PID.PrjPcb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]
2024-03-04 Schematic and asy Edit
    asy : removed all connections, rotated R5 to fit up down, flipped all green leds up/down
    schematics : edited the footprint of R5 to fit, changed power source to Vin 12V, and tidyied it up a bit
    [1391-Démonstrateur_PID.PrjPcb And 1391-Démonstrateur_PID.XLS]
2024-03-06 Schematic edits
    Modified footprint of rotation based potentiometer, pin 2 and 3 were swapped.
    Verified that turning clockwise would increase voltage (ie. ADC value)
    Also changed footprint of barrel potentiometer (previously only component on schematic was changed not the footprint itself).
    Added text indicating value of LEDs aswell as colour.
    Quick update in the PCB editor to update and verify validity of above edits to footprints
    [1391-Affichage led.SchDoc, 1391-Démonstrateur_PID.SCHLIB, 1391-Régulation.SchDoc, PRS11R-425F-S103B1.SchLib]
2024-03-08 Schematics edit
    Changed most of the SMD capacitors and resistors from 0603" to 0805"
    changed DrawnBy in Cartouche
    removed schematic bloc "Alimentation" and included the 12V input in the "Schéma bloc"
    moved cap.s around to better indicate where they go
    [1391-Affichage led.SchDoc, 1391-Alimentation.SchDoc, 1391-Démonstrateur_PID.PrjPcb, 1391-Microcontrôleur.SchDoc, 1391-Régulation.SchDoc, 1391-Schéma bloc.SchDoc]
2024-03-08 schematics corrections
    corrected the outputs/inputs of some of the schéma bloc
    [1391-Affichage led.SchDoc, 1391-Microcontrôleur.SchDoc, 1391-Régulation.SchDoc, 1391-Schéma bloc.SchDoc]
2024-03-08 added datasheets
    +5V regulator of the nucleo board
    schematics of the nucleo board in pdf
2024-03-11 change 0603 to 0805
    changed the last of the capacitors to 0805
    [1391-Microcontrôleur.SchDoc, 1391-Régulation.SchDoc]
2024-03-13 savepioint
    added file for 12V DC thingy
    just a lot
    [1391-Affichage led.SchDoc, 1391-Alimentation.SchDoc, 1391-Démonstrateur_PID.PrjPcb, 1391-Microcontrôleur.SchDoc, 1391-Régulation.SchDoc, 1391-Schéma bloc.SchDoc, Add Components.PcbLib, EJ503A.SchLib]
2024-03-13 sch edits
    changed K4 from mc74vhc1 to a 74lvc1g125gv_125
    added Supplier Price 1 to some components
    completed the BOM
    also added datasheet for current K4
    [1391-Affichage led.SchDoc, 1391-Démonstrateur_PID.PrjPcb, 1391-Démonstrateur_PID.SCHLIB, 1391-Microcontrôleur.SchDoc, 1391-Régulation.SchDoc, 74LVC1G125GV,125.stp, 74LVC1G125GV_125.SchLib, PRS11R-425F-S103B1.SchLib]
